angbres/Autonomous-Targeting-Turret/MEC101_Robot_Design_Project_Report.pdf

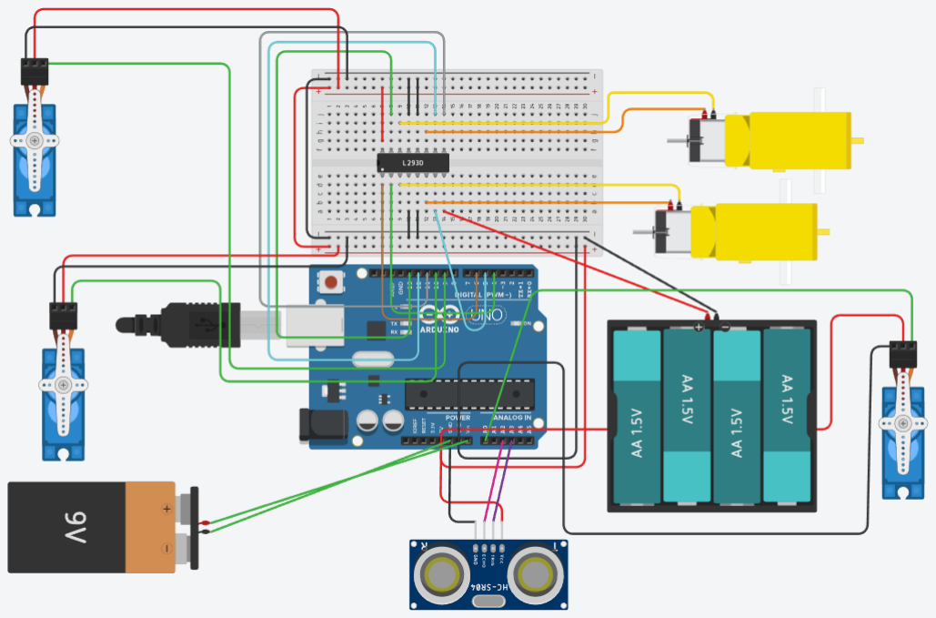
[picture p8: figure]
